P33a/ScaraTwo/Images/IMG20251230002046.jpg

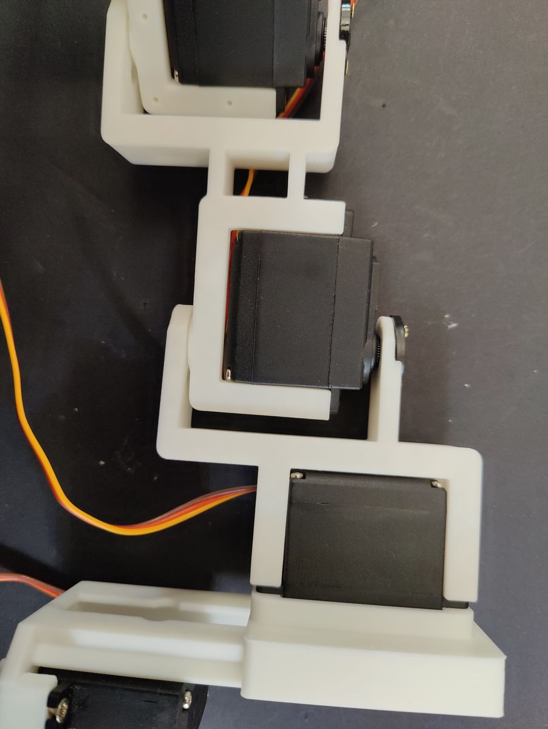
Images/IMG20251230002046.jpg
