P33a/ScaraTwo/STL/claw_left.stl

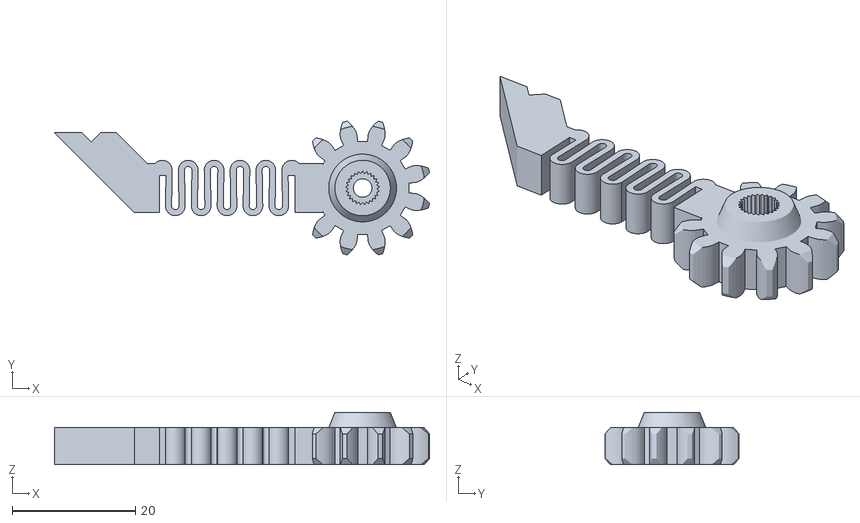
[picture p2: CAD file, 2025-12-30]
STL/claw_left.stl
60.9 x 21.7 x 8.50
