P33a/ScaraTwo/STL/servo55_spacer.stl

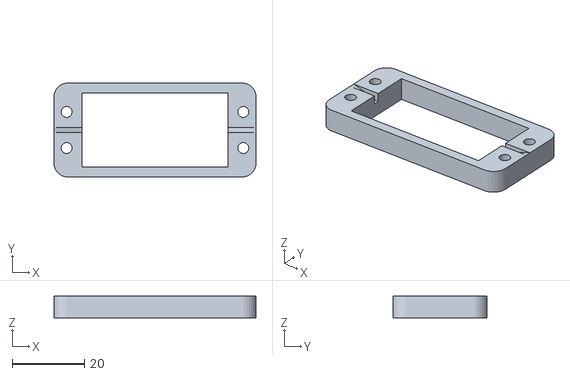
[picture p3: CAD file, 2025-12-30]
STL/servo55_spacer.stl
56.0 x 26.0 x 6.00
