P33a/ScaraTwo/STL/claw_left_v3.stl

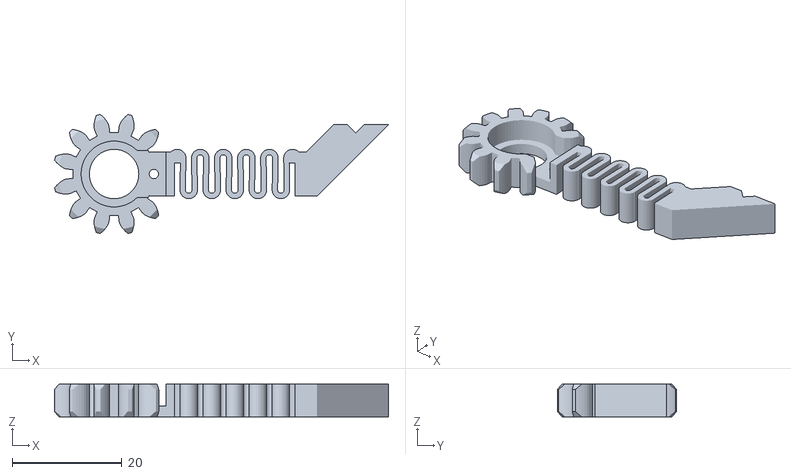
[picture p4: CAD file, 2025-12-30]
STL/claw_left_v3.stl
60.9 x 21.7 x 6.00
