P33a/ScaraTwo/STL/servo55_sleeve.stl

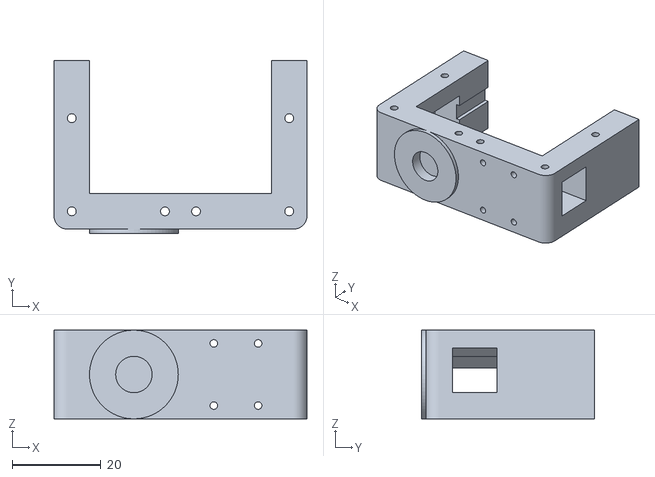
[picture p5: CAD file, 2025-12-30]
STL/servo55_sleeve.stl
57.0 x 39.0 x 20.0
