P33a/ScaraTwo/STL/scara55_slider.stl

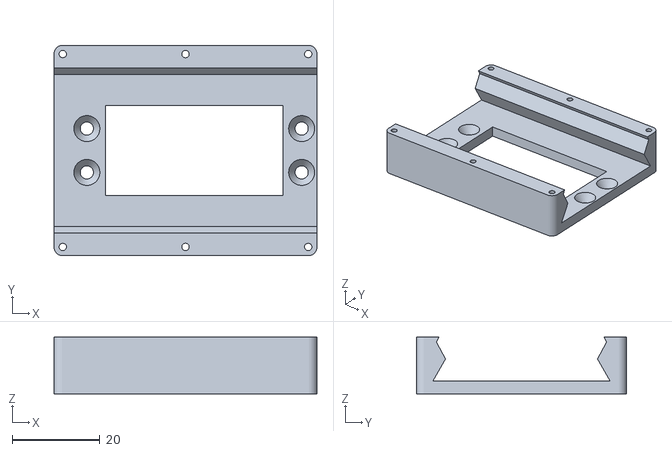
[picture p6: CAD file, 2025-12-30]
STL/scara55_slider.stl
60.0 x 48.0 x 13.0
