P33a/ScaraTwo/STL/as5600_support_55.stl

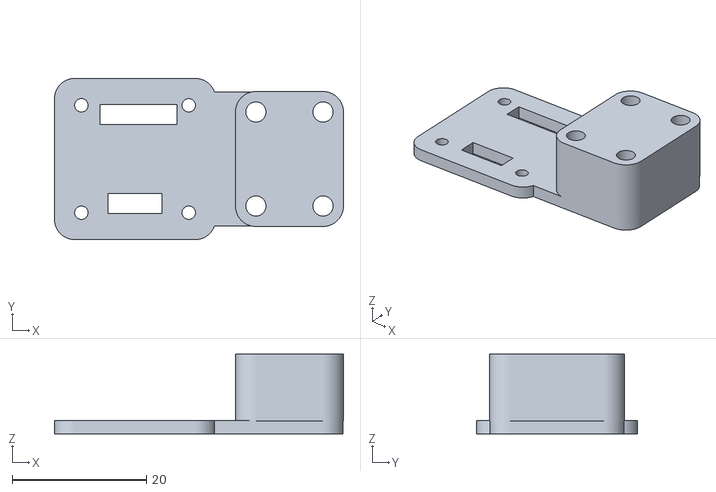
[picture p7: CAD file, 2025-12-30]
STL/as5600_support_55.stl
43.0 x 24.0 x 11.9
