P33a/ScaraTwo/STL/scara55_base.stl

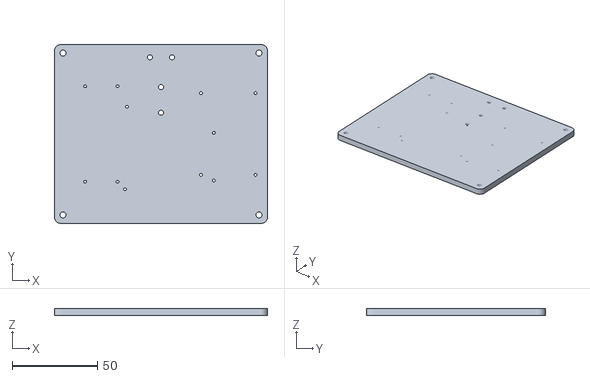
[picture p8: CAD file, 2025-12-30]
STL/scara55_base.stl
125.0 x 105.0 x 4.00
