P33a/ScaraTwo/STL/vlx_support_55_v3.stl

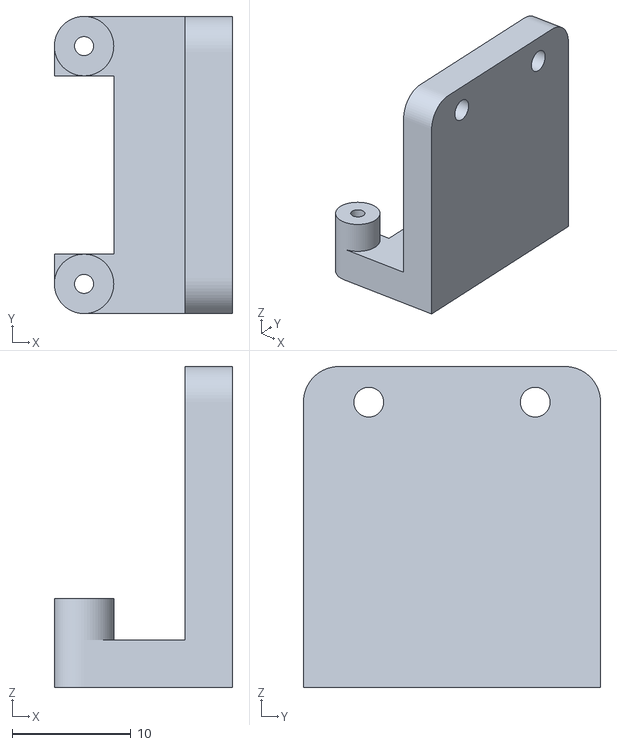
[picture p9: CAD file, 2025-12-30]
STL/vlx_support_55_v3.stl
15.0 x 25.0 x 27.0
