P33a/ScaraTwo/STL/scara55_rail_v3.stl

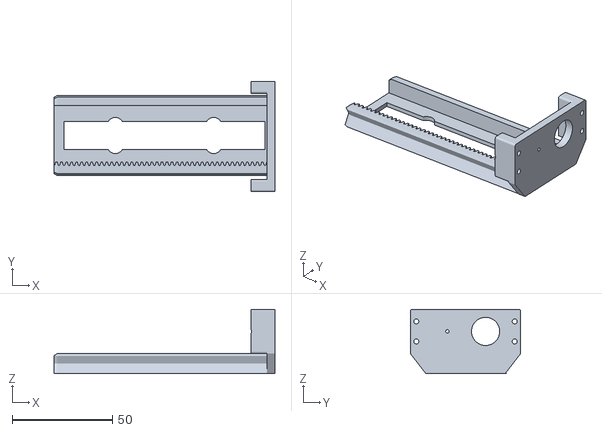
[picture p10: CAD file, 2025-12-30]
STL/scara55_rail_v3.stl
110.0 x 55.0 x 32.1
