P33a/ScaraTwo/STL/scara55_link_two.stl

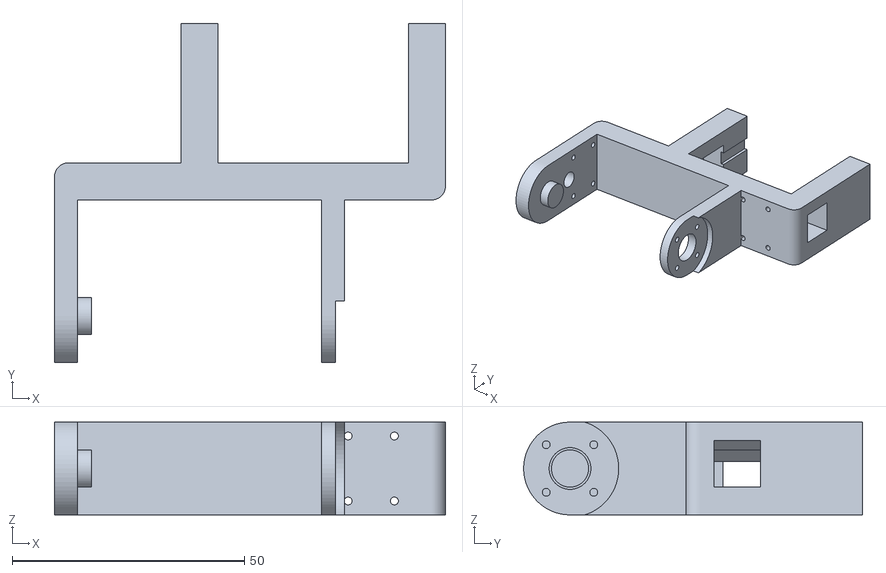
[picture p11: CAD file, 2025-12-30]
STL/scara55_link_two.stl
84.2 x 73.0 x 20.0
