P33a/ScaraTwo/STL/scara55_link_one.stl

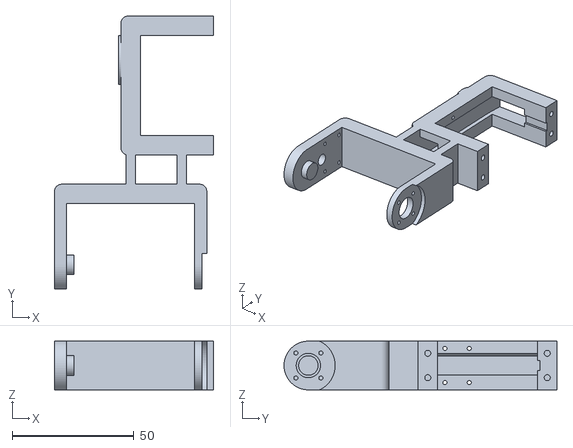
[picture p12: CAD file, 2025-12-30]
STL/scara55_link_one.stl
65.2 x 112.0 x 20.0
