P33a/ScaraTwo/STL/scara55_tower.stl

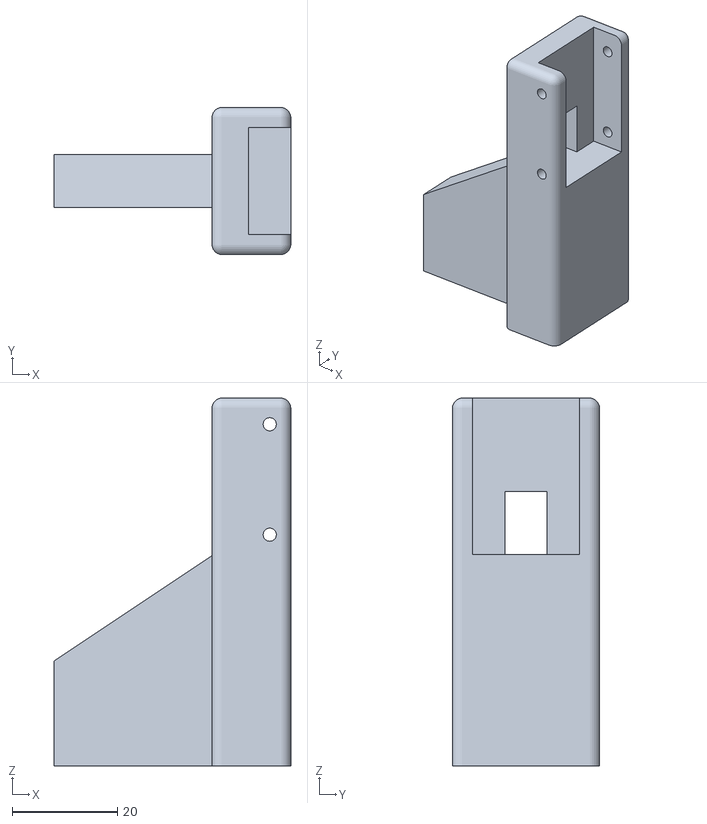
[picture p13: CAD file, 2025-12-30]
STL/scara55_tower.stl
45.0 x 28.0 x 70.0
