P33a/ScaraTwo/STL/claw_pin.stl

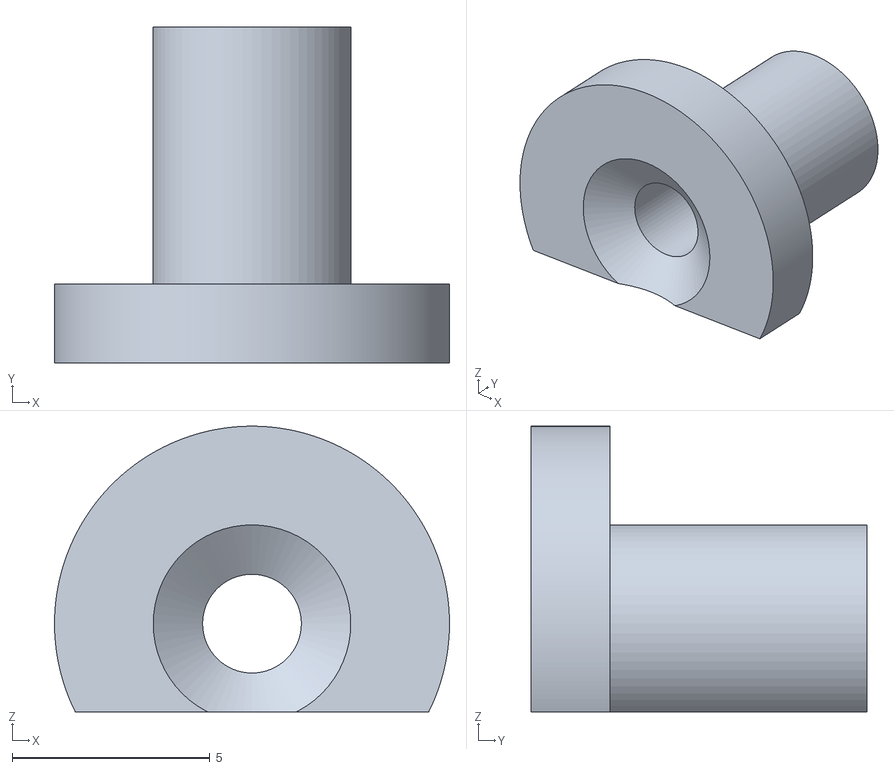
[picture p14: CAD file, 2025-12-30]
STL/claw_pin.stl
10.0 x 8.50 x 7.23
