P33a/ScaraTwo/STL/slider55_gear.stl

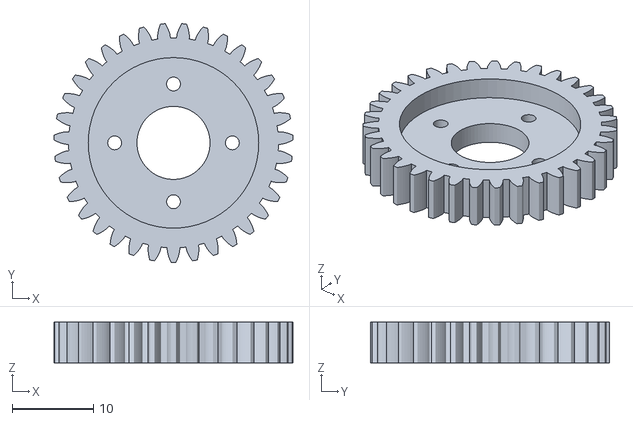
[picture p15: CAD file, 2025-12-30]
STL/slider55_gear.stl
29.4 x 29.4 x 5.00
