P33a/ScaraTwo/STL/vlx_support_55_v2.stl

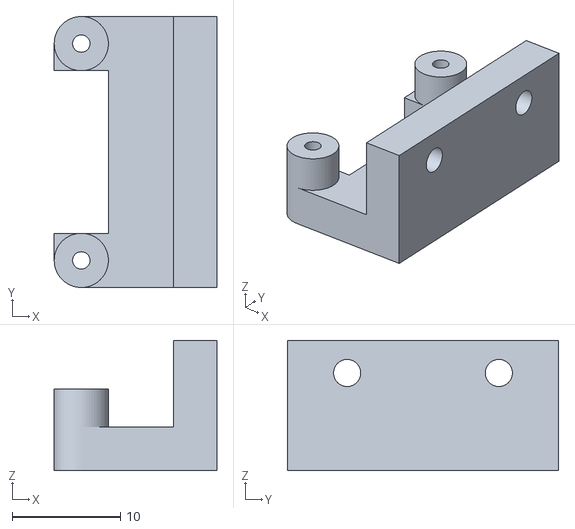
[picture p16: CAD file, 2025-12-30, an earlier design]
STL/vlx_support_55_v2.stl
15.0 x 25.0 x 12.0
