P33a/ScaraTwo/(list of files, cad)

Other CAD files:
STL/claw_right.stl
