P33a/ScaraTwo/Physical Assembly.md

First, the base must be connected to the main tower:

It uses four 3 x 16 mm self tapping screws

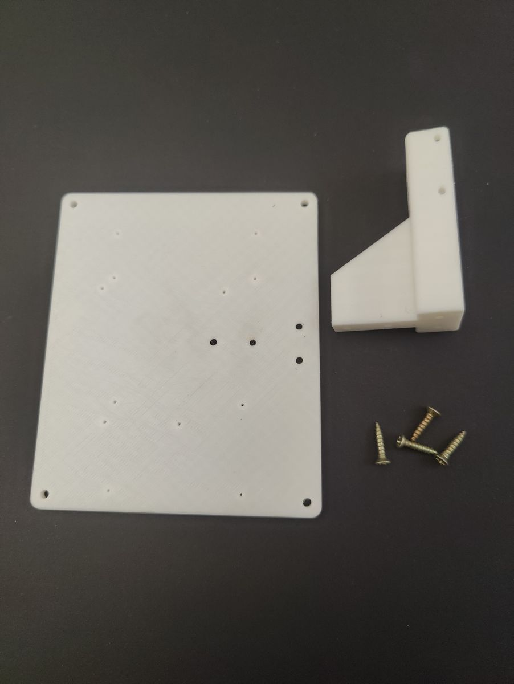
[picture p17: Images/IMG20251128013951.jpg]
 
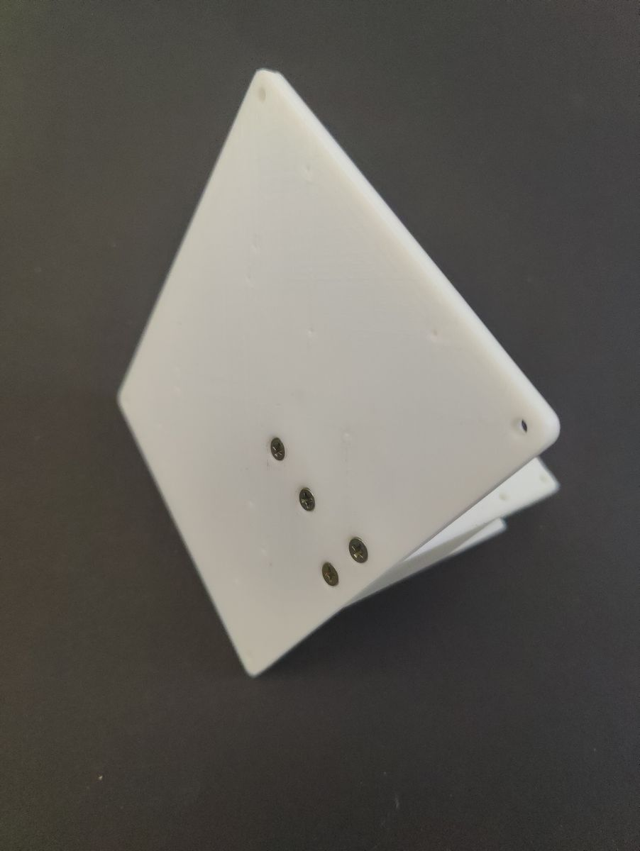
[picture p18: Images/IMG20251128014258.jpg]
 

Final result

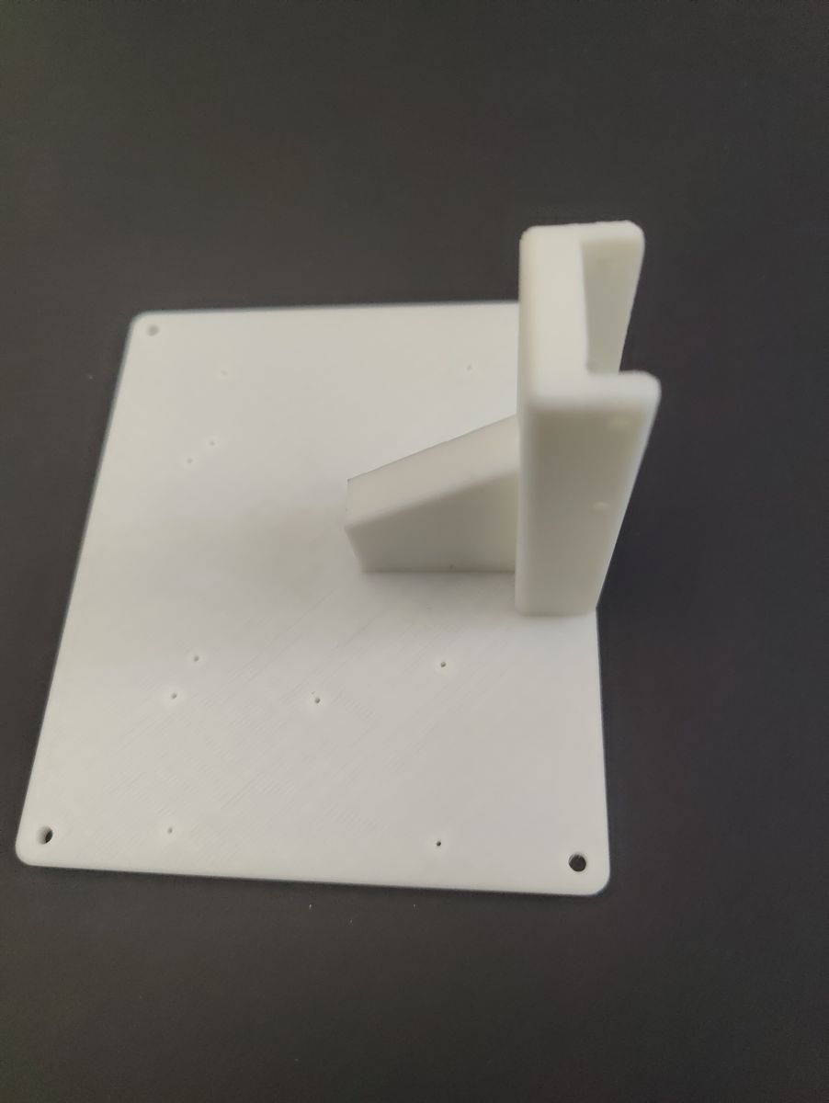
[picture p19: Images/IMG20251128014222.jpg]
 

Connect the Servo sleeve using four 2.5 x 12 mm self tapping screws

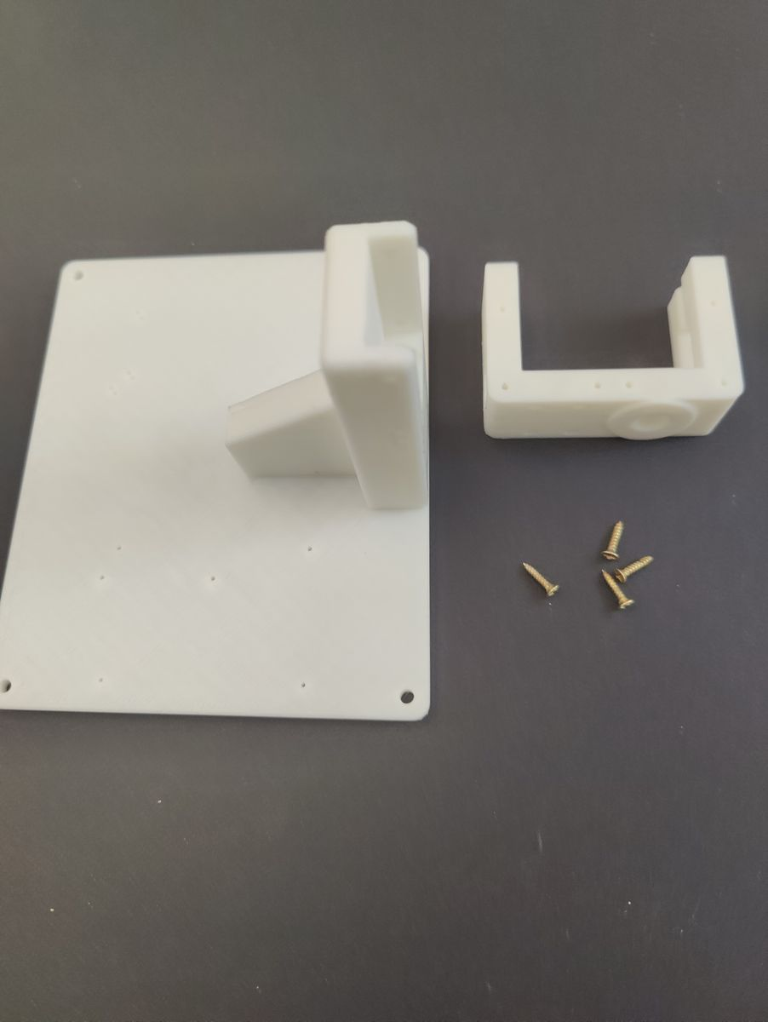
[picture p20: Images/IMG20251128014451.jpg]
 
 
But first attach the Servo to the sleeve using four 2.5 x 16 mm self tapping screws

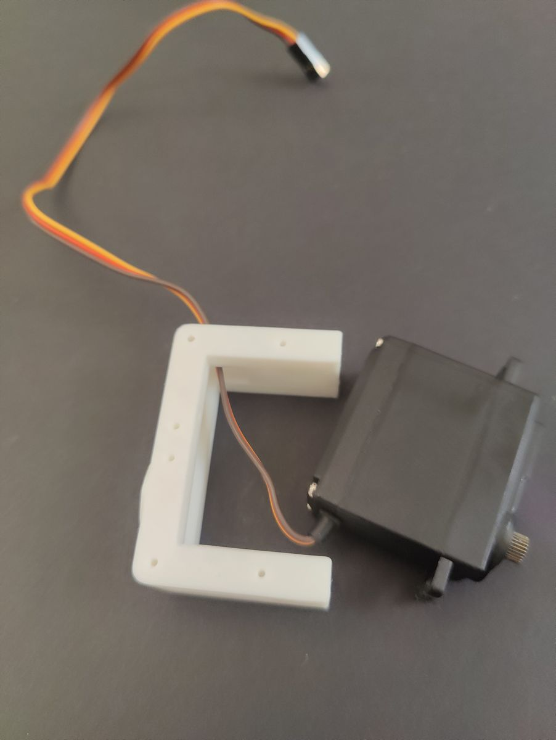
[picture p21: Images/IMG20251128014633.jpg]

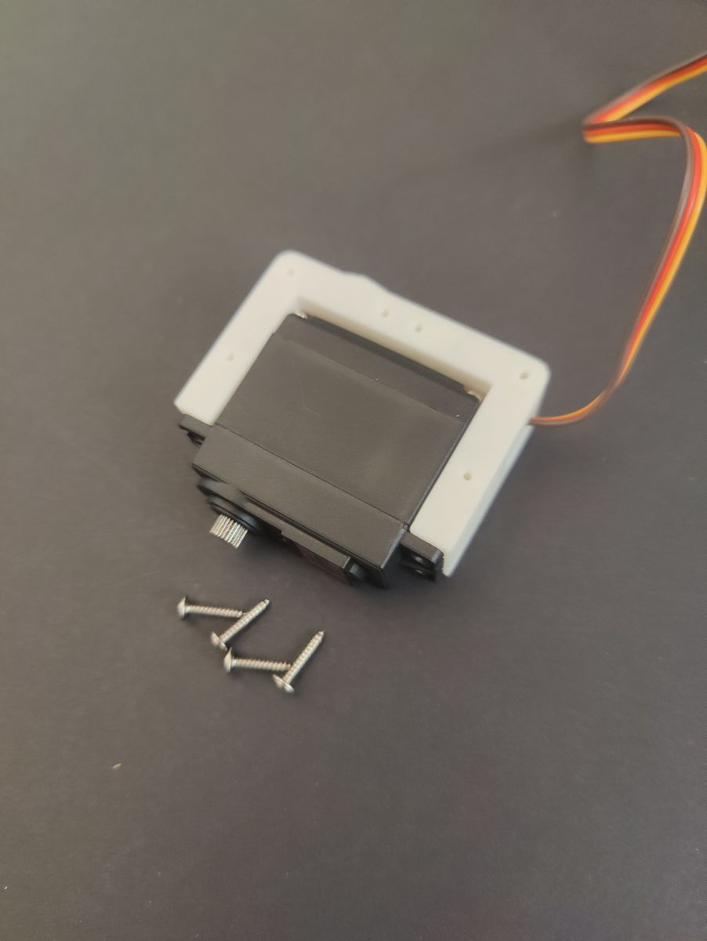
[picture p22: Images/IMG20251128015108.jpg]

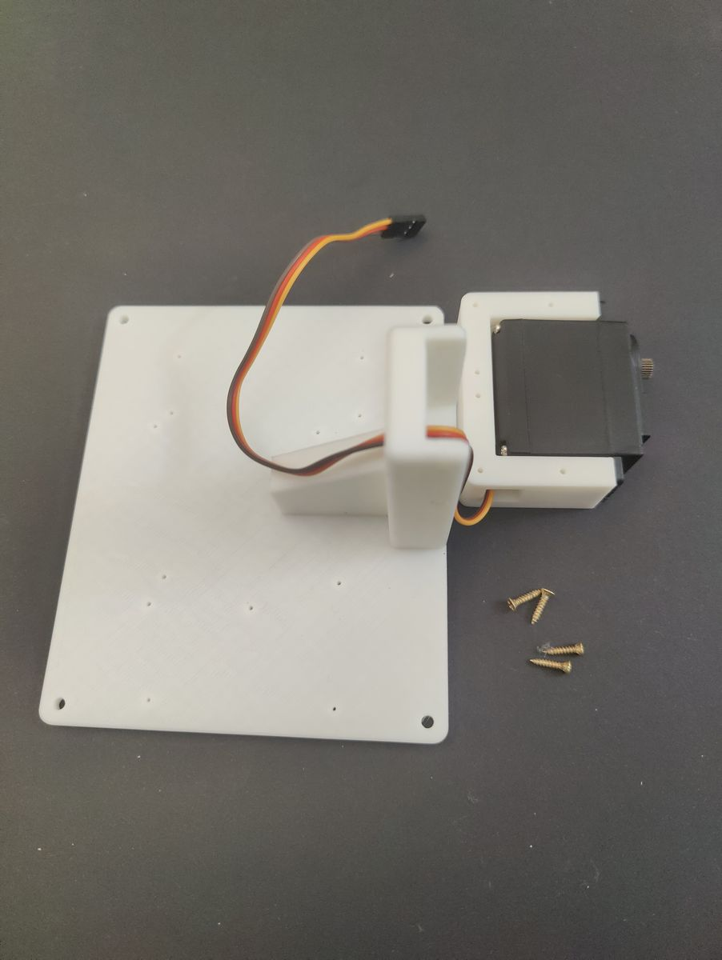
[picture p23: Images/IMG20251128015253.jpg]

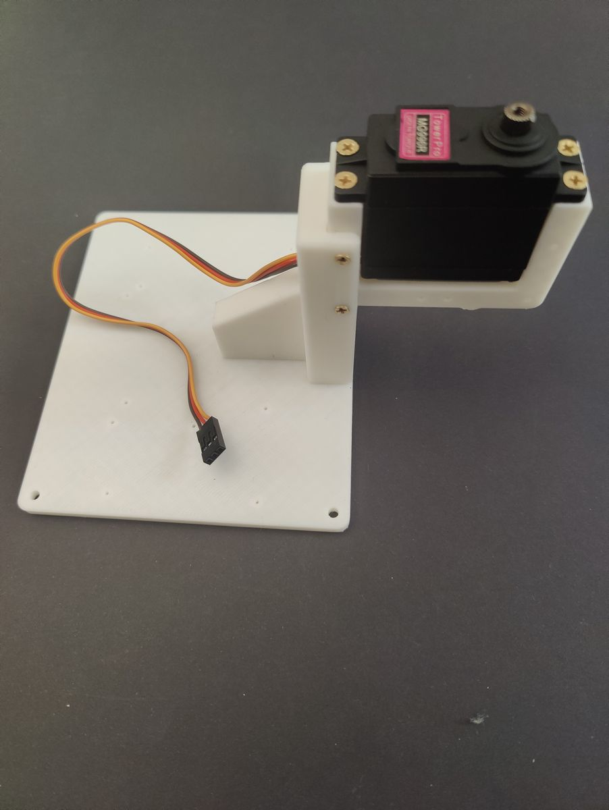
[picture p24: Images/IMG20251128015450.jpg]


Then, attach the second Servo to the first link.
Again, use four 2.5 x 16 mm self tapping screws

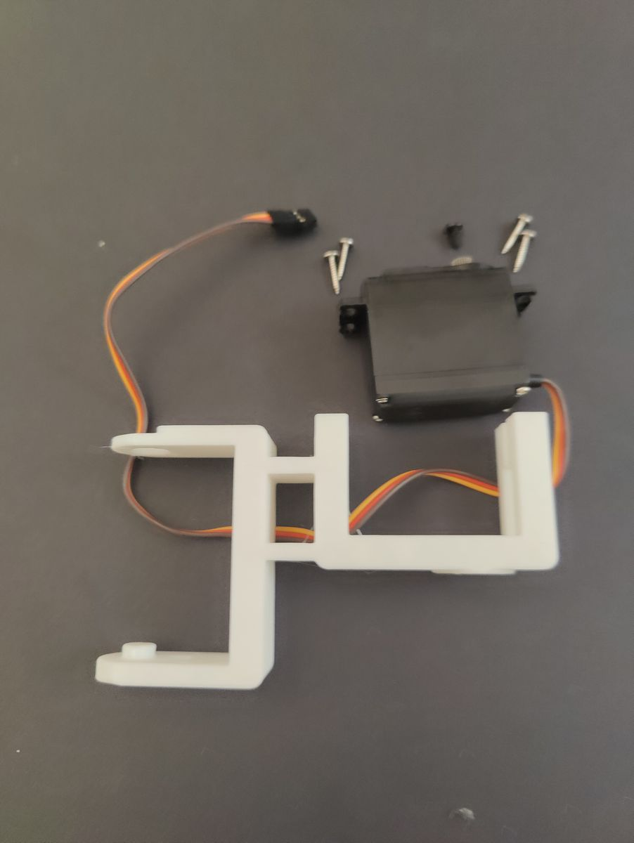
[picture p25: Images/IMG20251128015823.jpg]

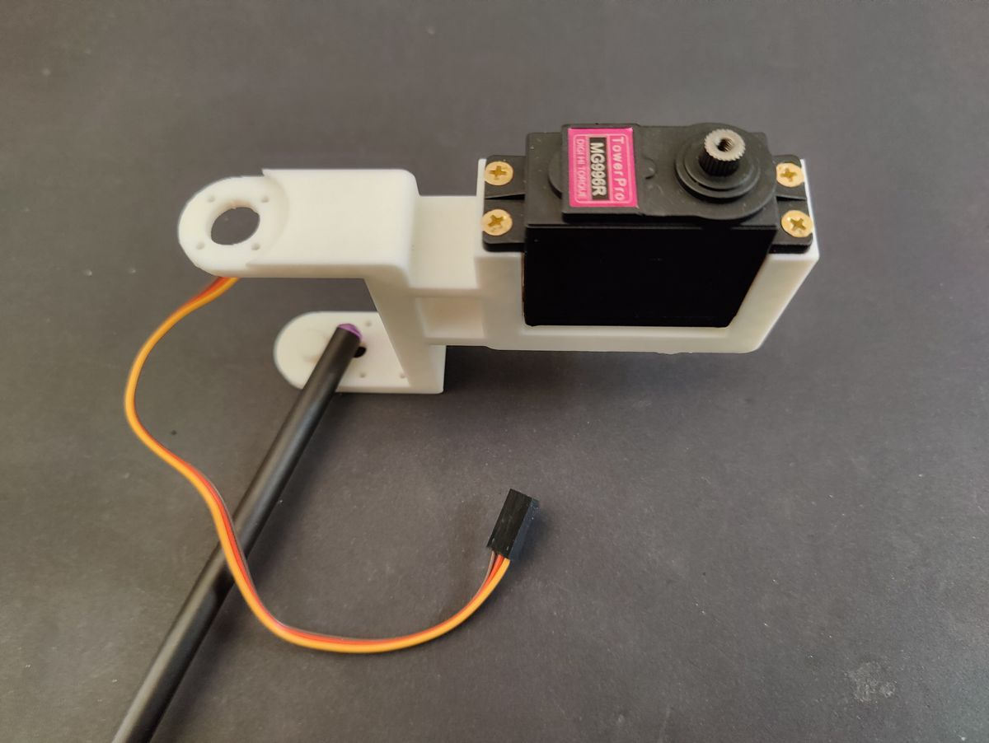
[picture p26: Images/IMG20251229225830.jpg]
  

The Servo round horn must be attached to the first link 
using two (or four) 2 x 6 mm self tapping screws

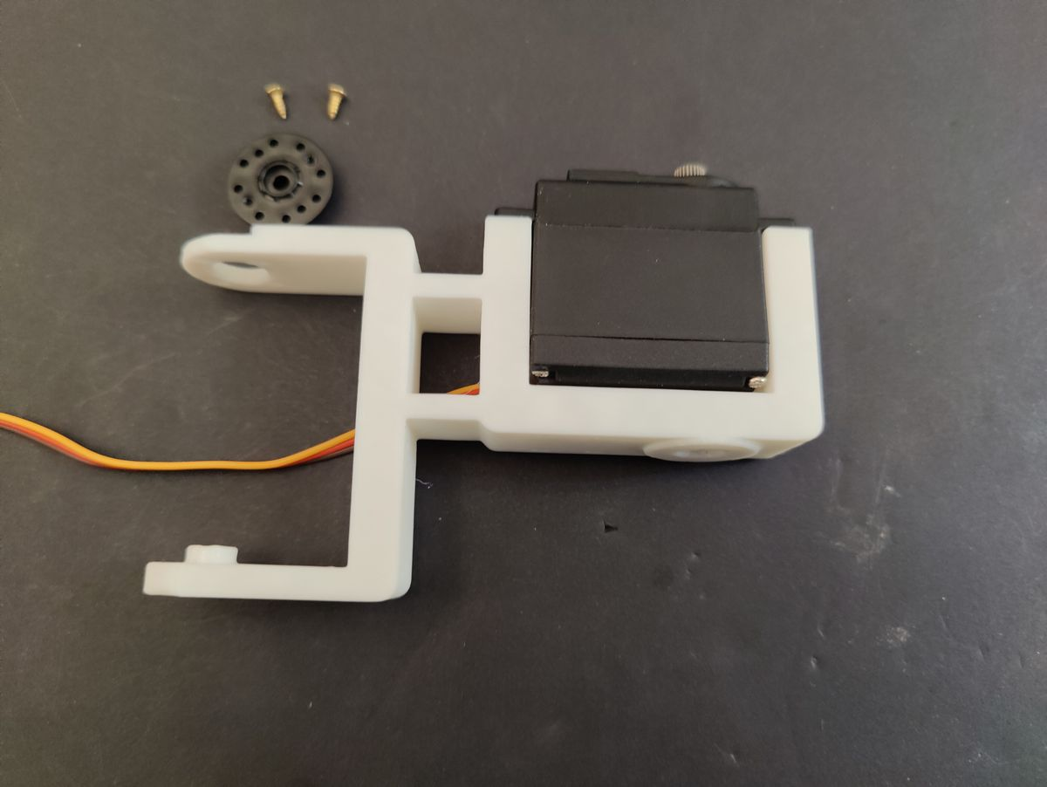
[picture p27: Images/IMG20251229231113.jpg]

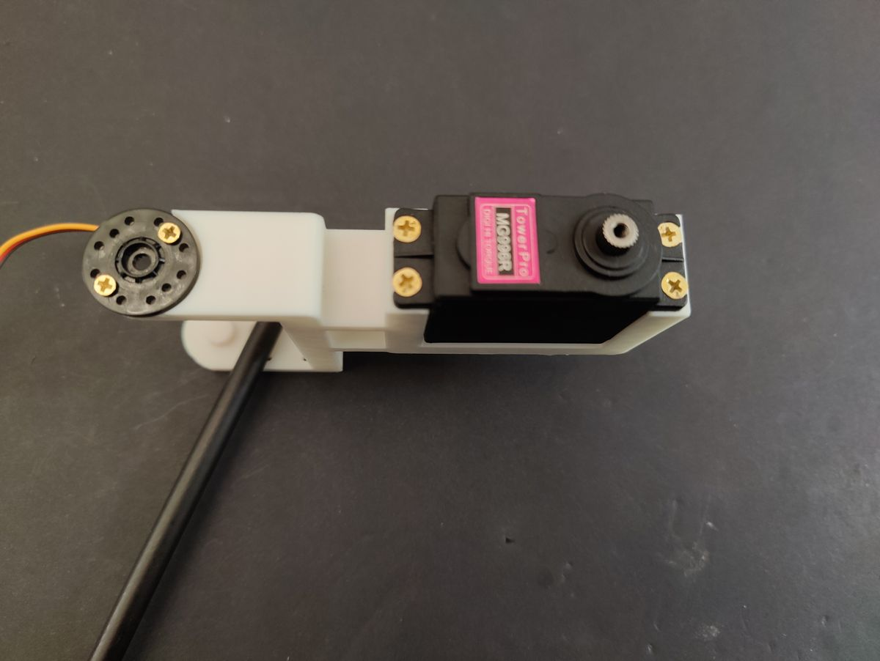
[picture p28: Images/IMG20251229231228.jpg]
  

Press the horn to insert it on the first servo.
Use the supplied screw to hold it.

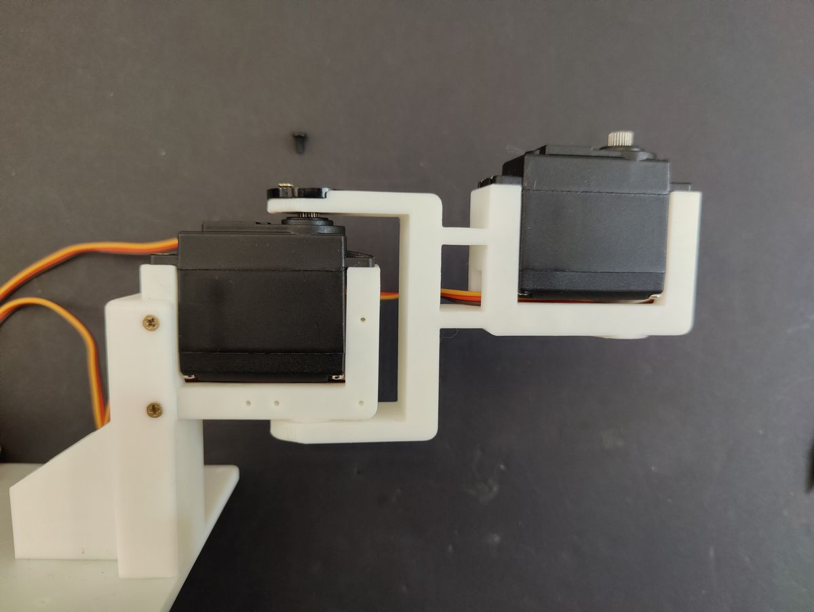
[picture p29: Images/IMG20251229231446.jpg]


To assemble the Z joint you will need four  2.5 x 20 mm self tapping screws

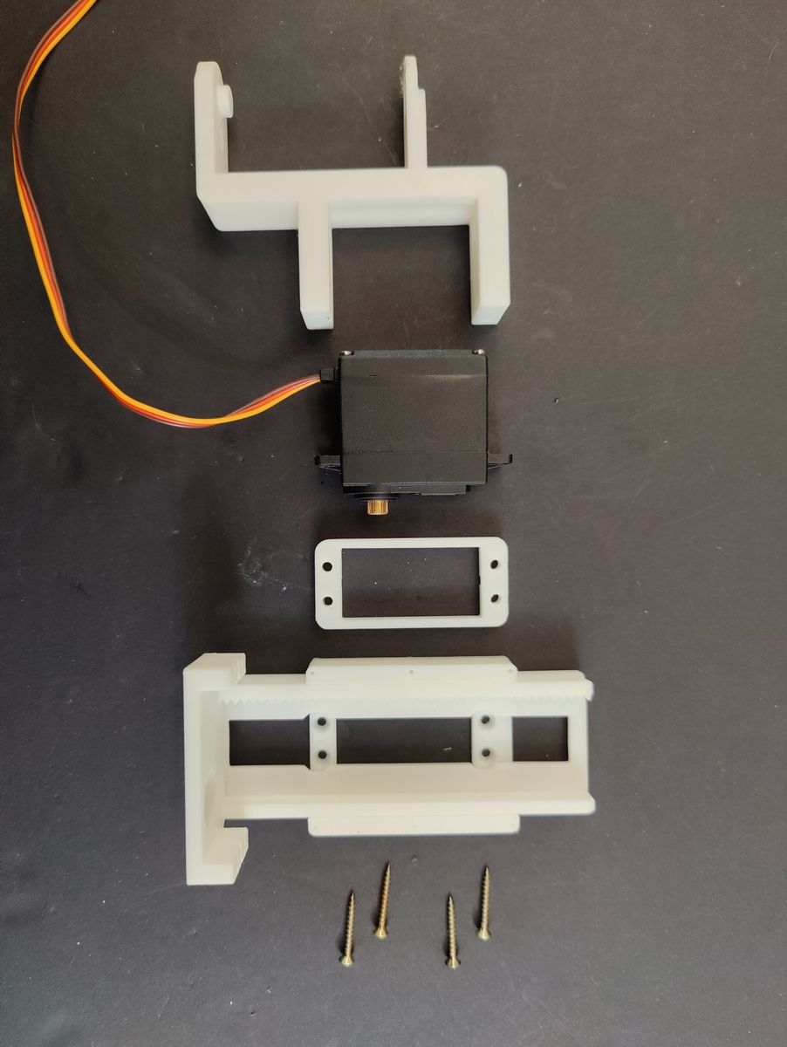
[picture p30: Images/IMG20251229234037.jpg]

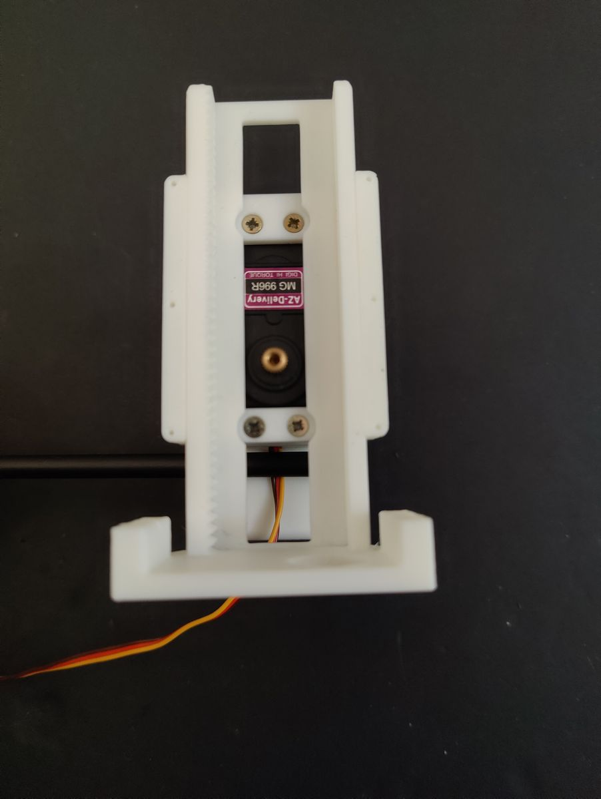
[picture p31: Images/IMG20251229234408.jpg]


The gear must be attached to the round horn using two (or four) 2 x 6 mm self tapping screws

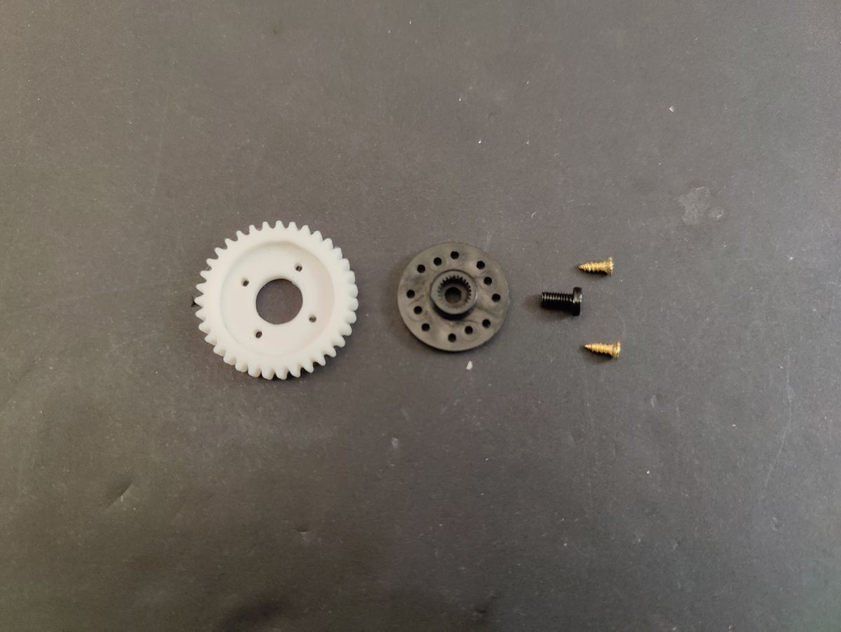
[picture p32: Images/IMG20251229234536.jpg]


and then use the supplied screw to atttach it to the servo.

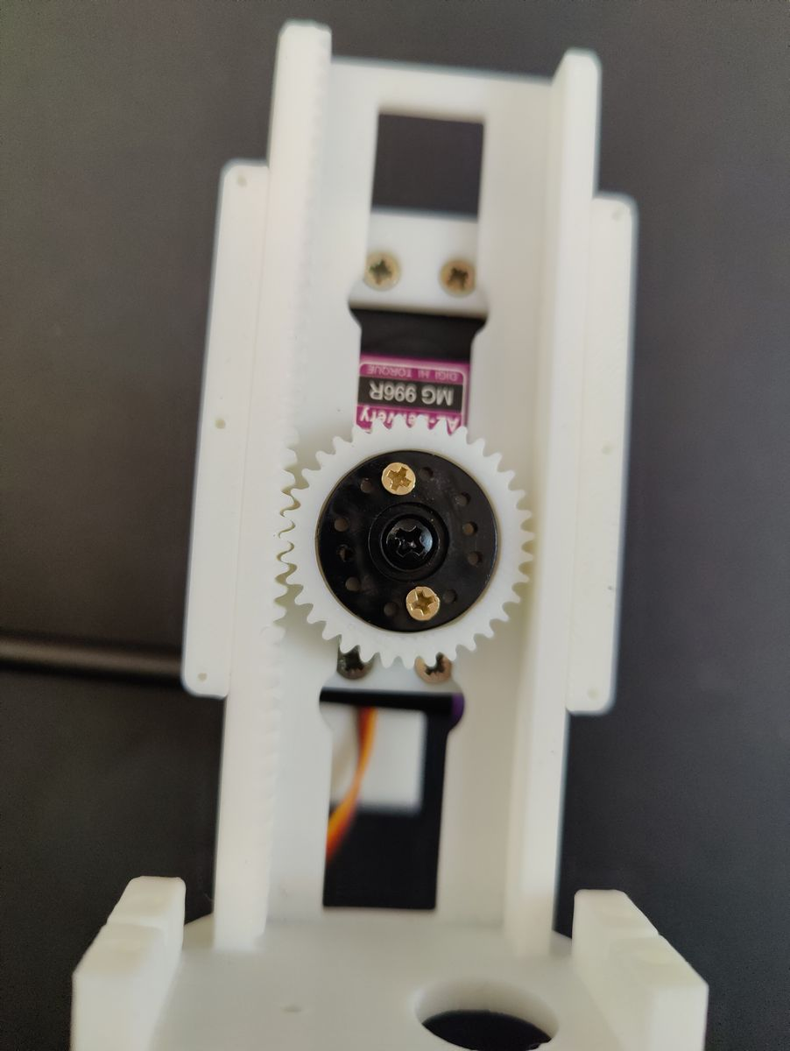
[picture p33: Images/IMG20251229234749.jpg]


The claw Servo must be attached using four 2.5 x 12 mm self tapping screws

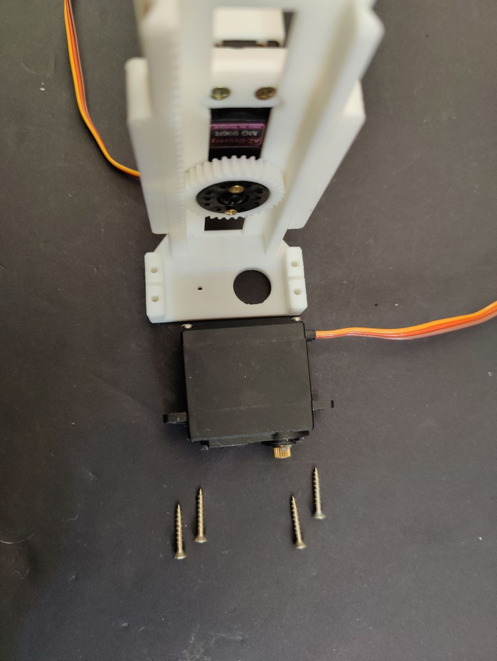
[picture p34: Images/IMG20251229235720.jpg]

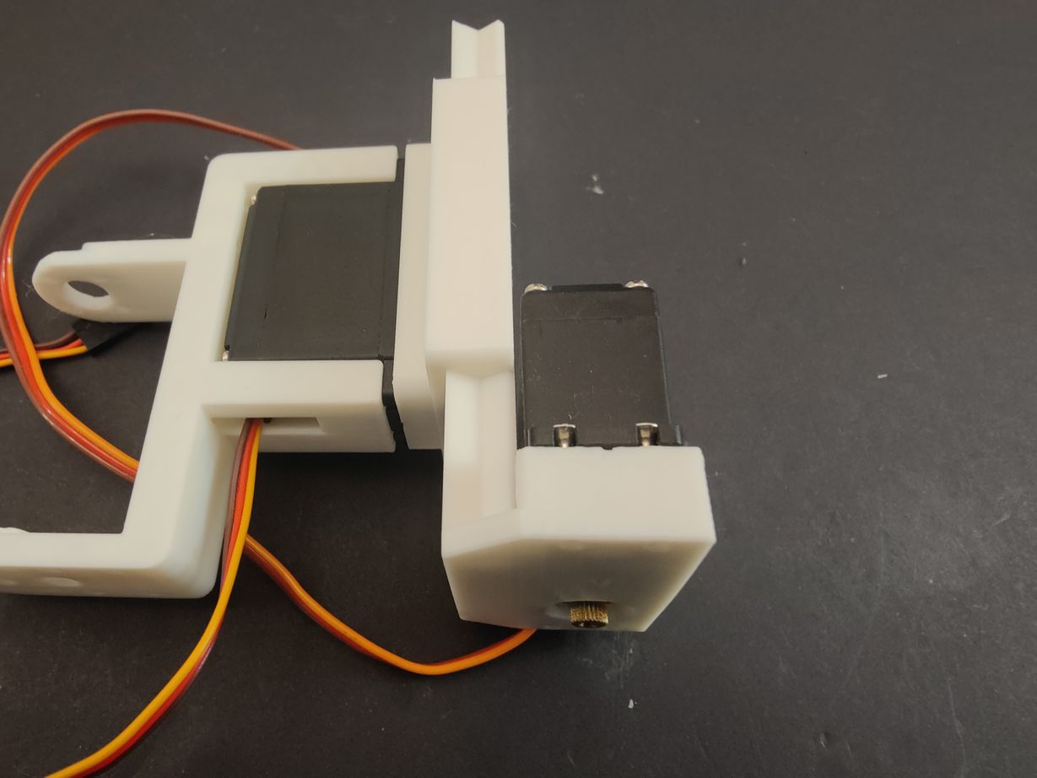
[picture p35: Images/IMG20251230000154.jpg]


One claws wil be attached  to the servo using the servo screw and a modified horn

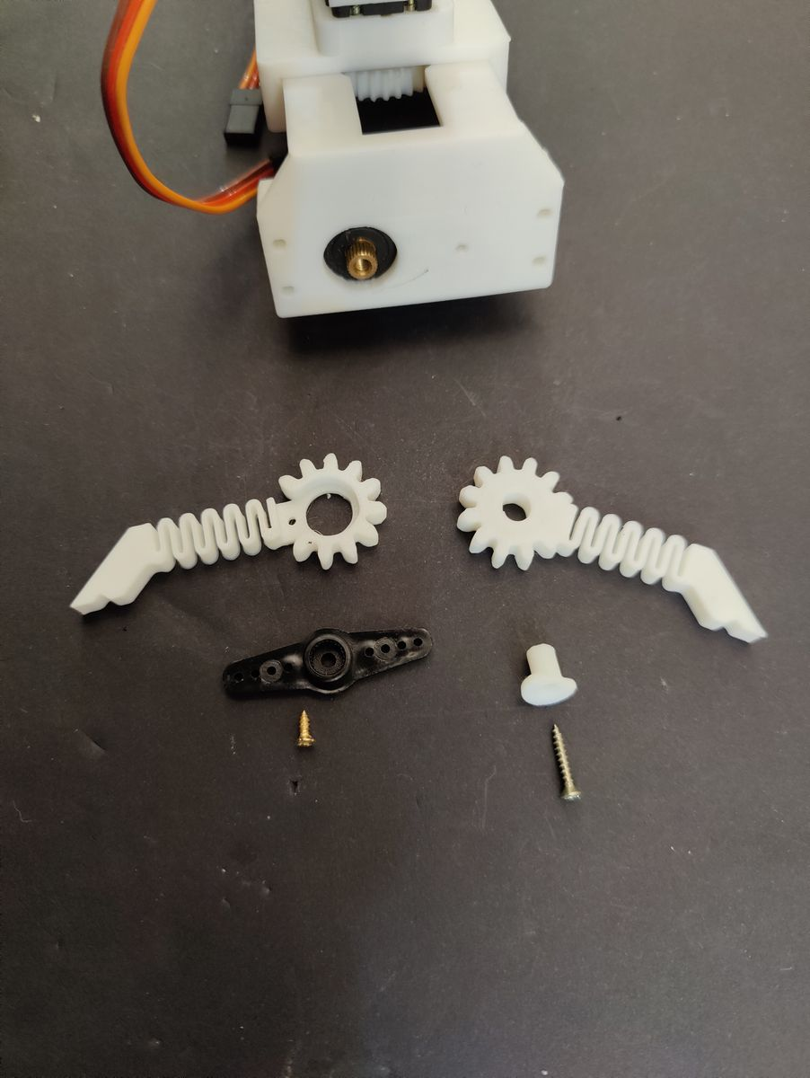
[picture p36: Images/IMG20251230000459.jpg]

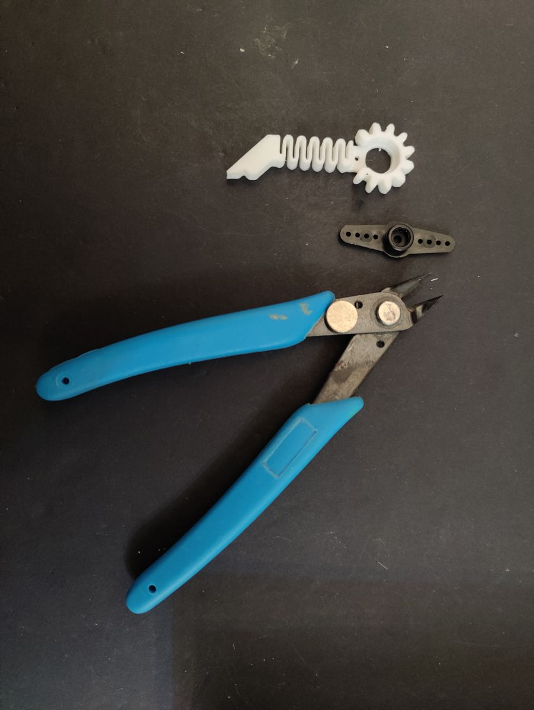
[picture p37: Images/IMG20251230000532.jpg]


The original horn with the first cut:

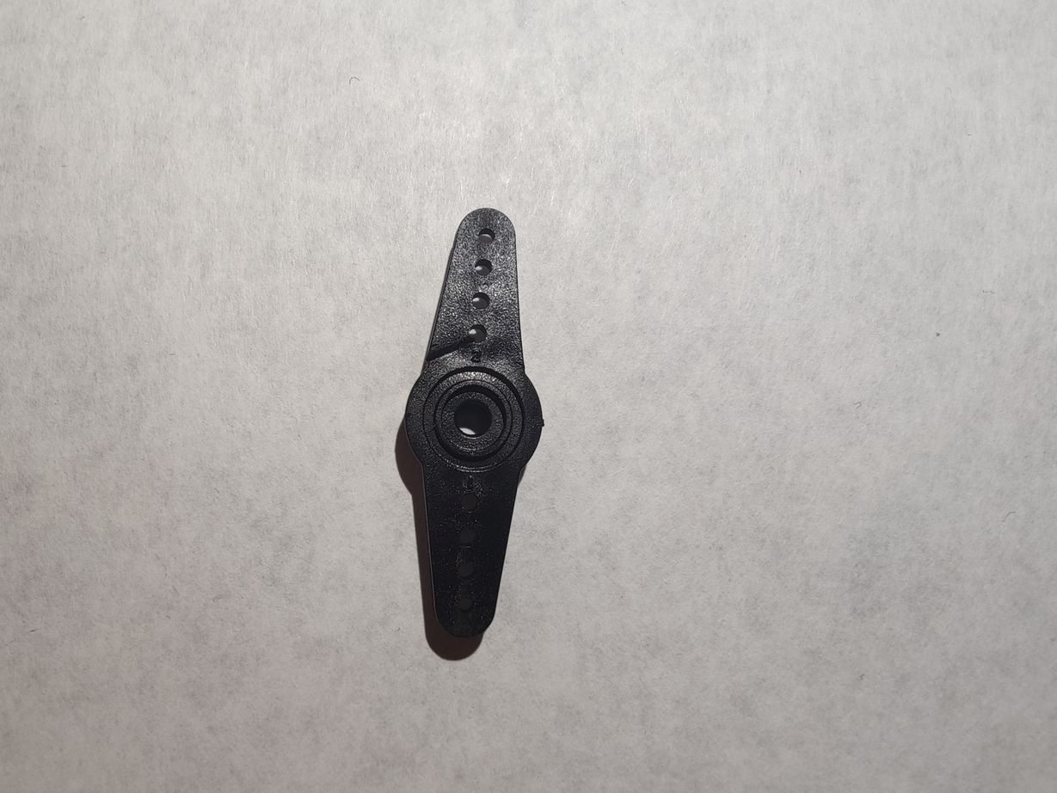
[picture p38: Images/IMG20251230000651.jpg]


The horn with the final modification and attached to the claw using a 2 x 6 mm self tapping screw

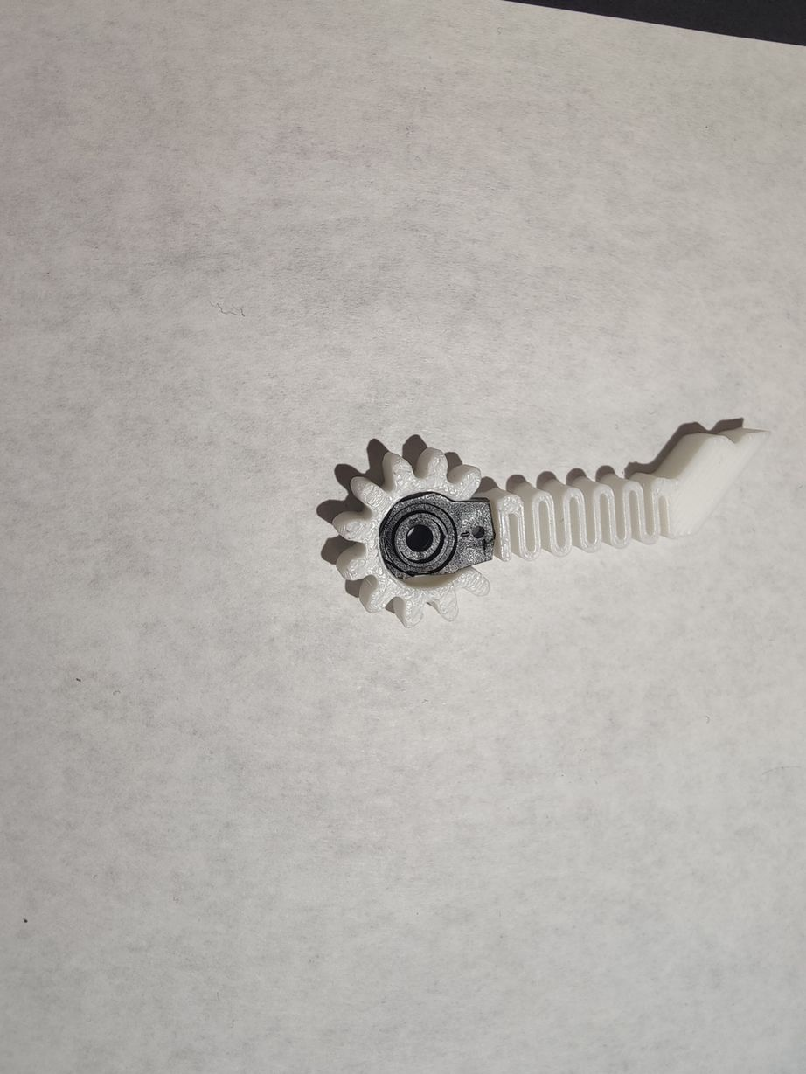
[picture p39: Images/IMG20251230000946.jpg]


The other claw attache using a 2 x 12 mm self tapping screw

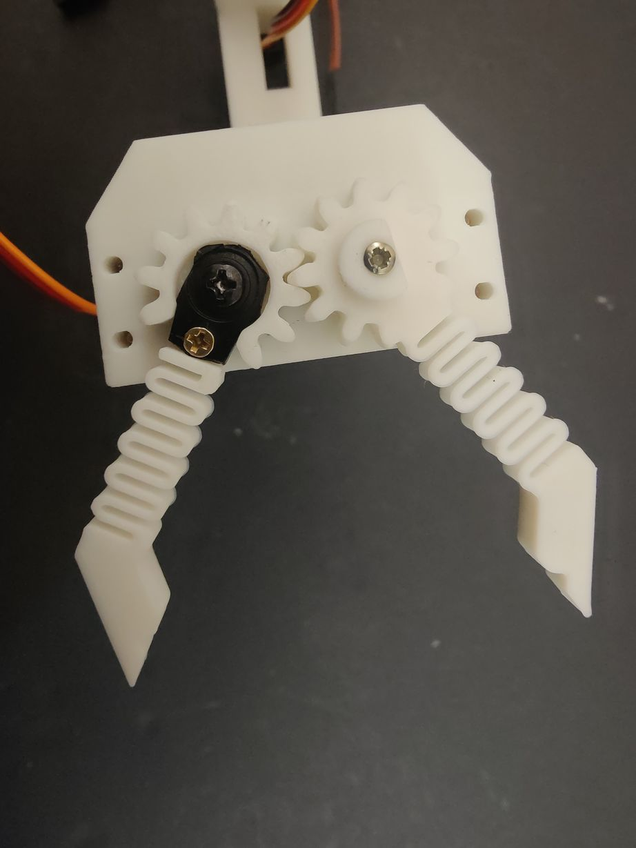
[picture p40: Images/IMG20251230001525.jpg]


The final connection between the first two links and the rest of the arm

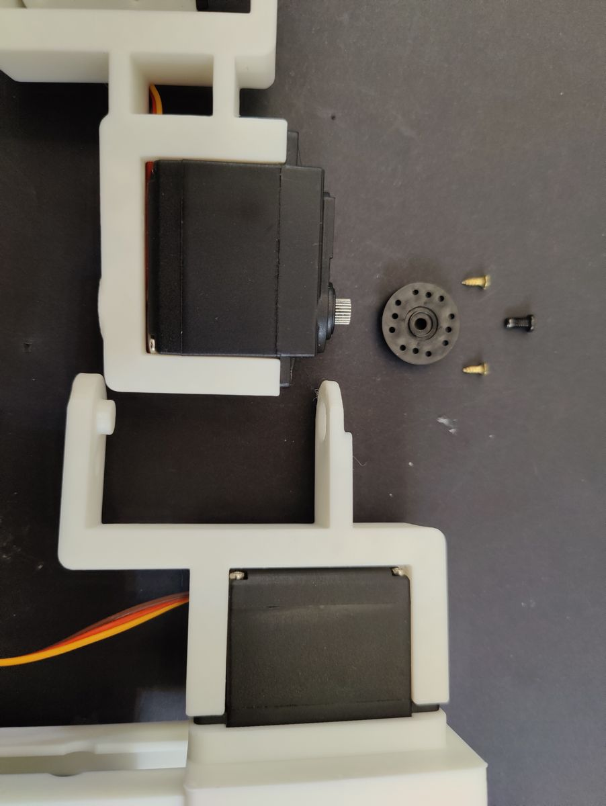
[picture p41: Images/IMG20251230001711.jpg]
final

final

Now you can secure the servo driver board and the Pi Pico motherboard.
First, the Pi Pico motherboard using four 2 x 10 mm self tapping screws and four washers as the booard holes are larger than the screw heads.

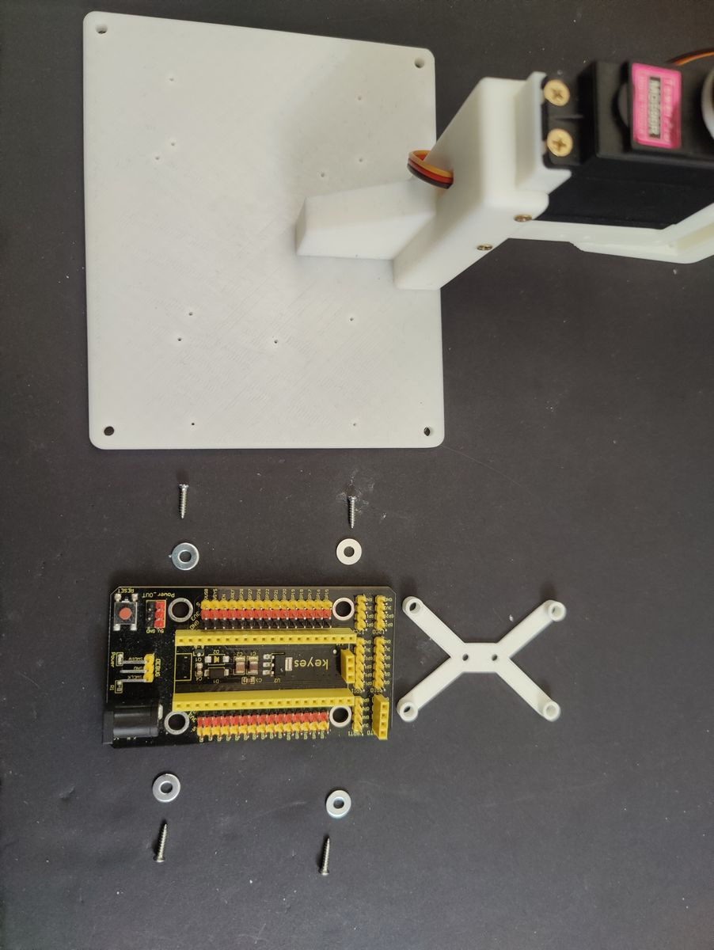
[picture p42: Images/IMG20260118232020.jpg]

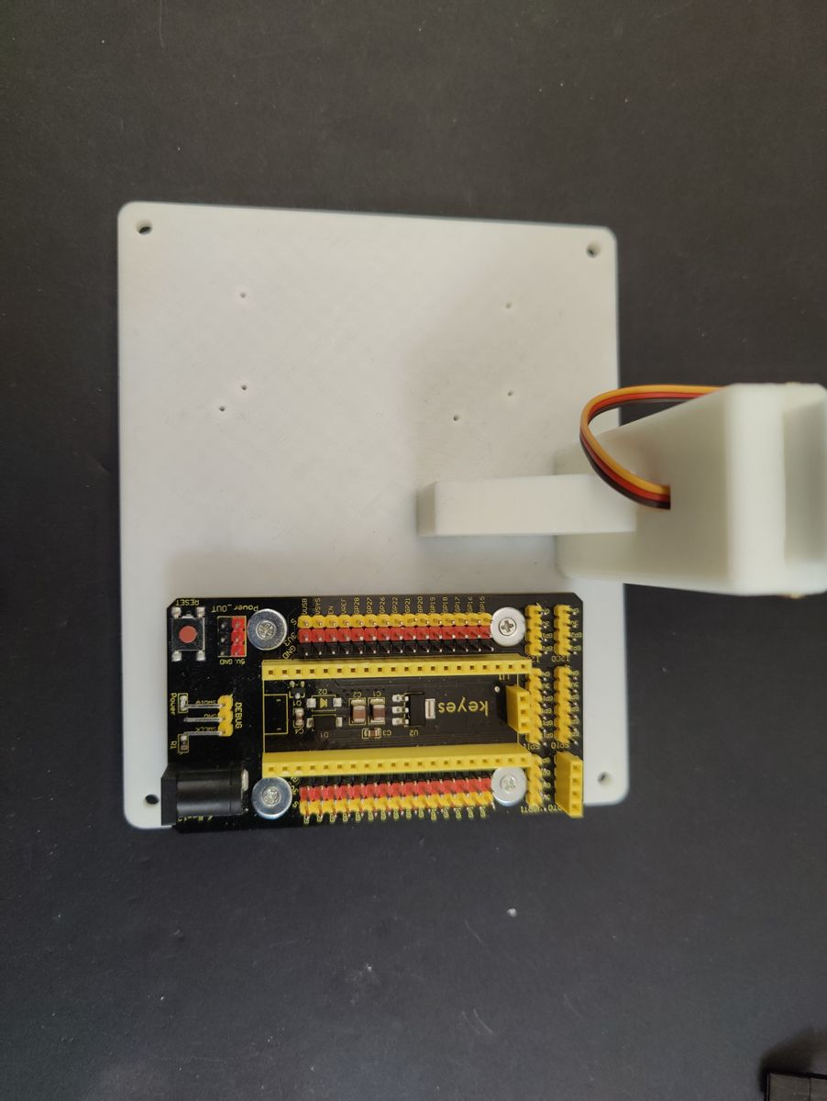
[picture p43: Images/IMG20260118232312.jpg]


Then, the servo driver board using four 2 x 10 mm self tapping screws.

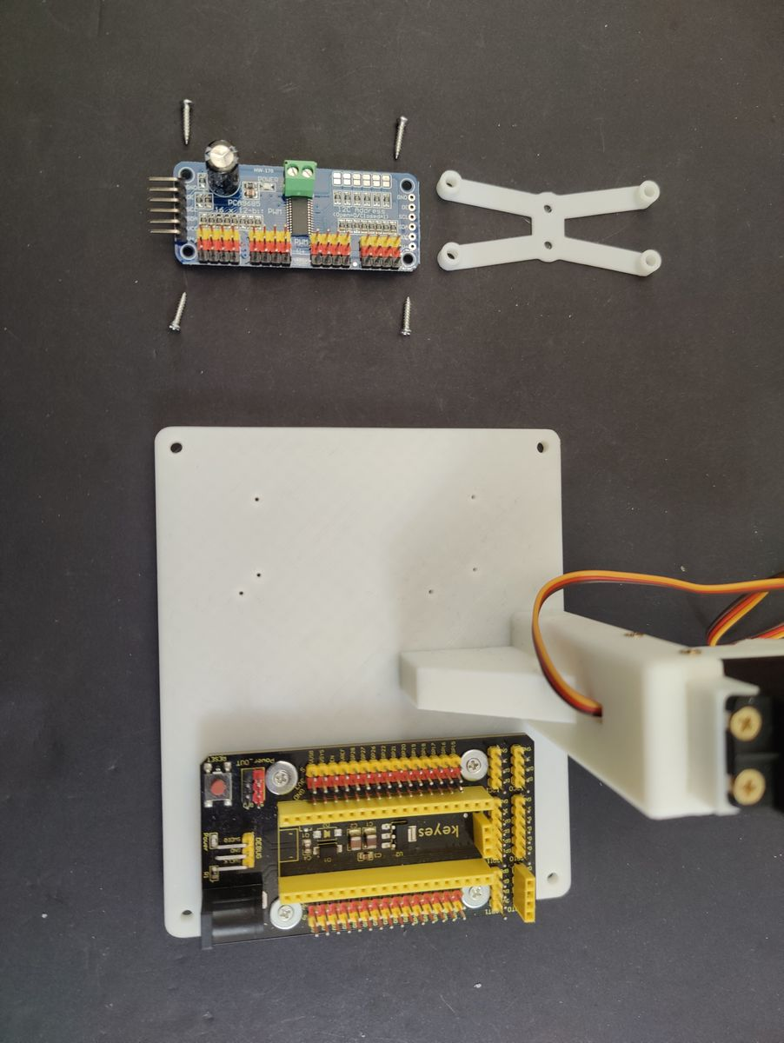
[picture p44: Images/IMG20260118232356.jpg]

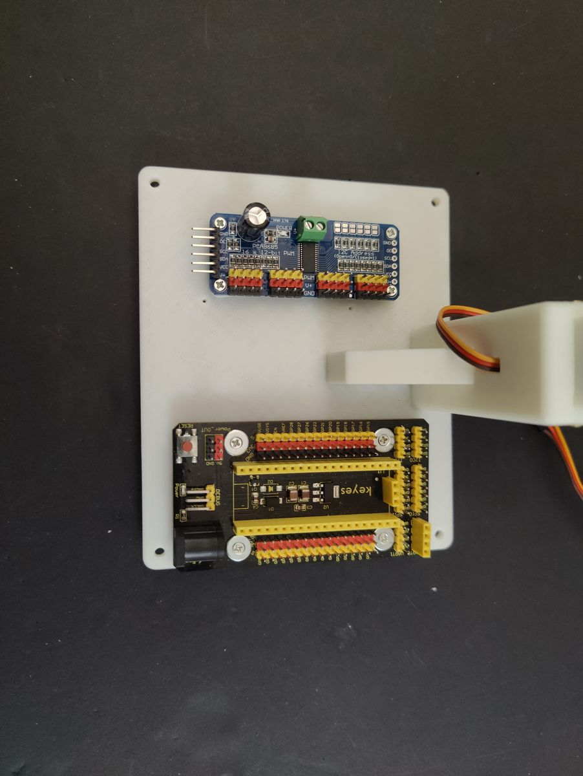
[picture p45: Images/IMG20260118232608.jpg]


Now, for the optional sensors

If the first two servos are 360º servos you will need an extra position sensor for those joints

You must secure the sensor to its support using four 2 x 6 mm self tapping screws.

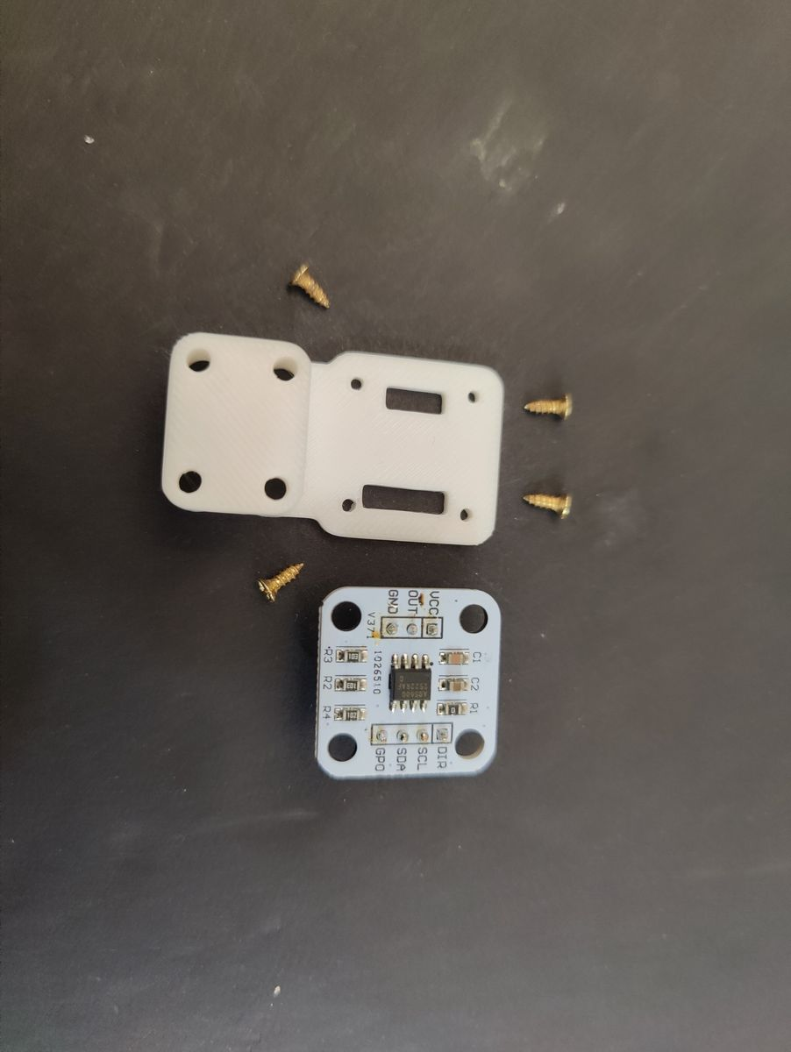
[picture p46: Images/IMG20260118234412.jpg]

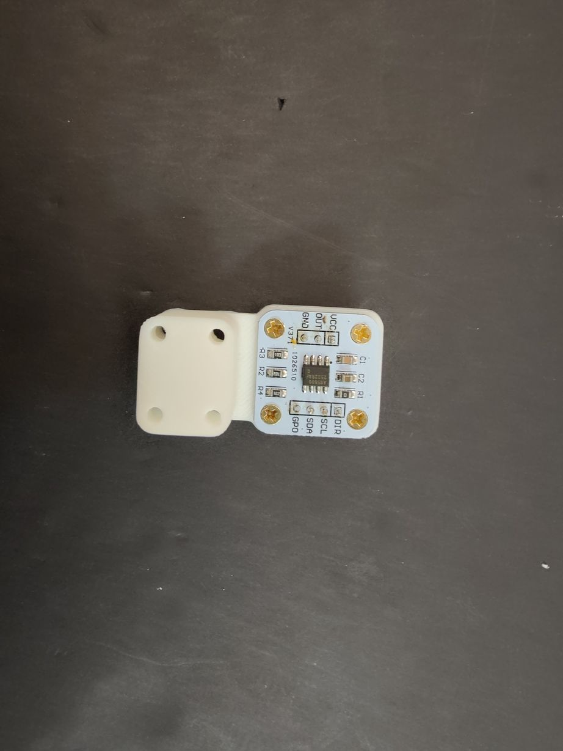
[picture p47: Images/IMG20260118234547.jpg]


Then you can secure it to the link using four 2 x 10 mm self tapping screws.

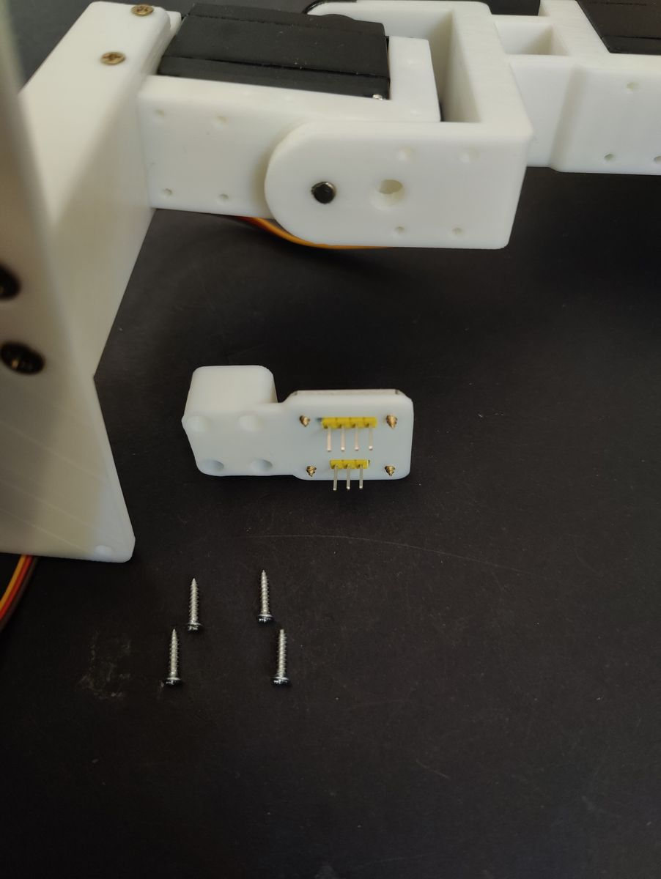
[picture p48: Images/IMG20260118234703.jpg]

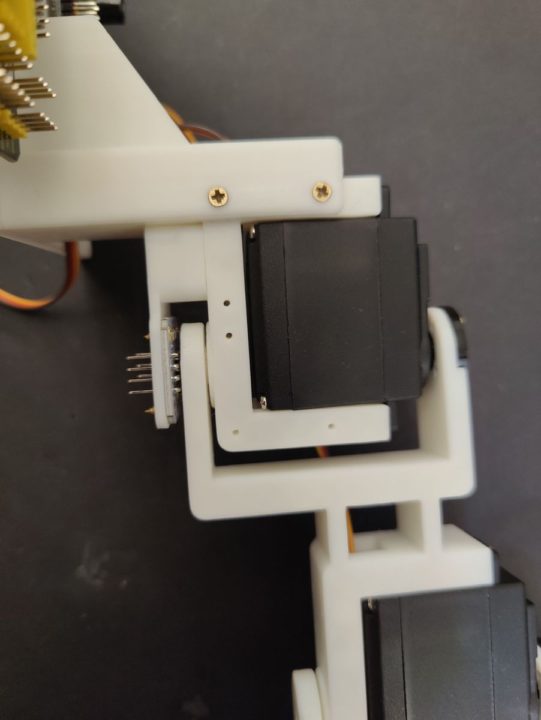
[picture p49: Images/IMG20260118234837.jpg]


If you want the distance sensor connected to the arm
First you must secure the sensor to its support using two 2 x 10 mm self tapping screws.

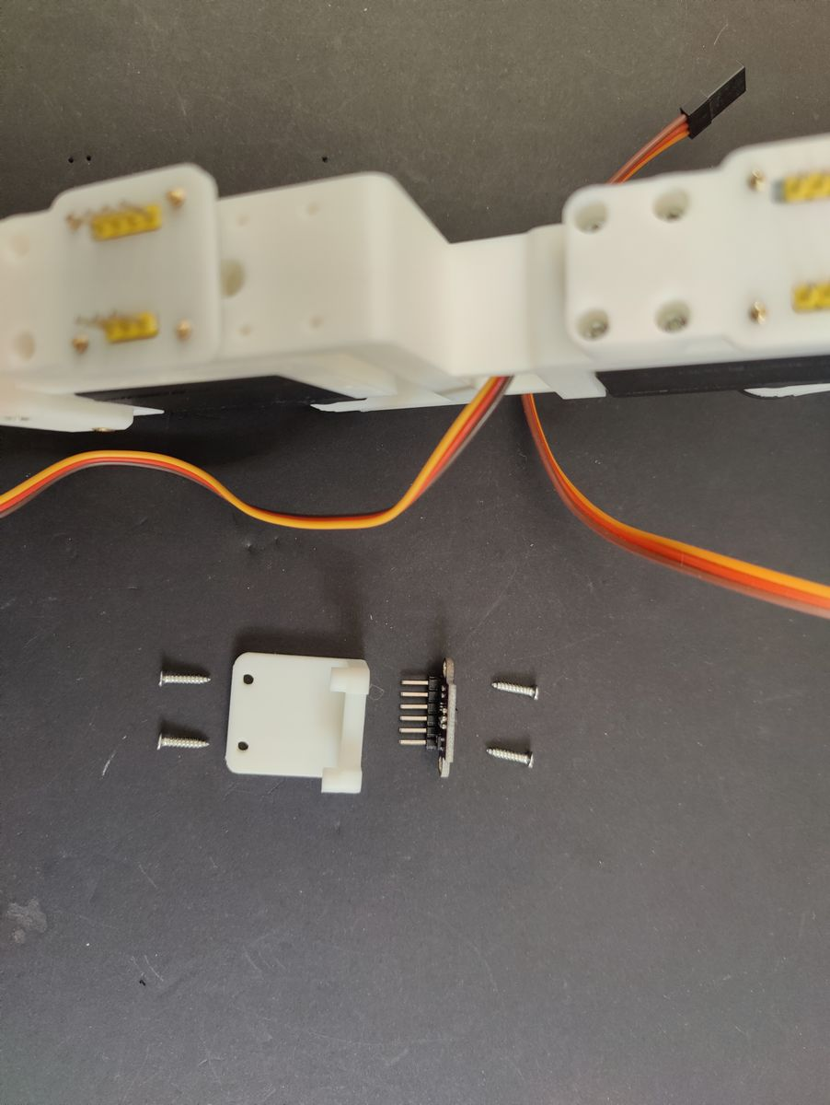
[picture p50: Images/IMG20260119001107.jpg]

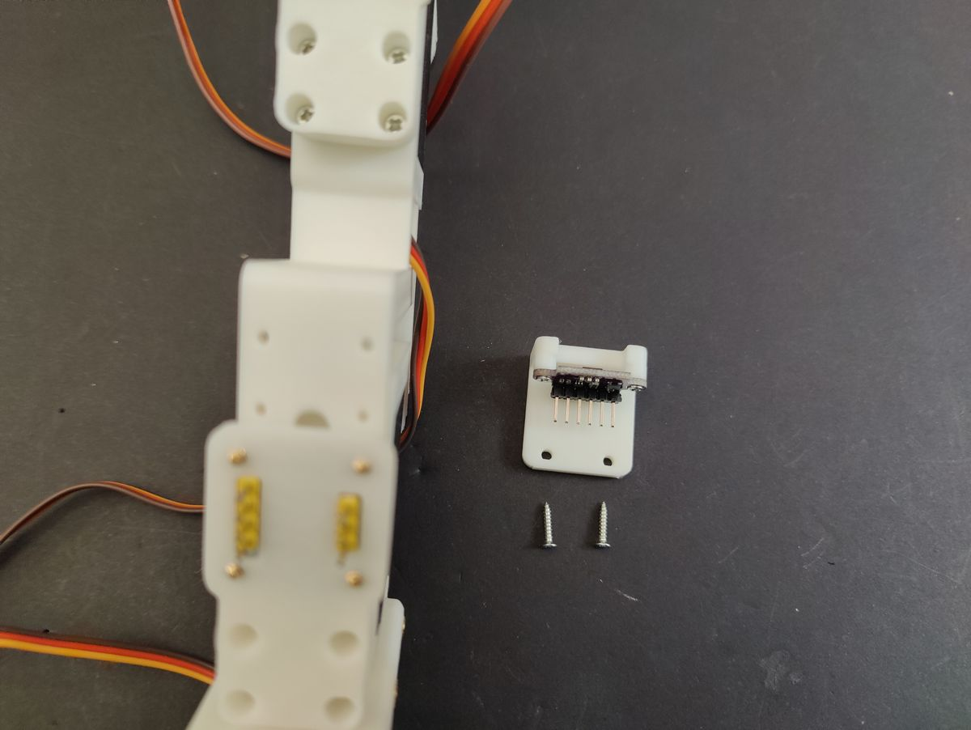
[picture p51: Images/IMG20260119001307.jpg]


Then you can secure it to the link using four 2 x 10 mm self tapping screws.
Do not forget to press the magnet inside the hole alligned with the link axis.

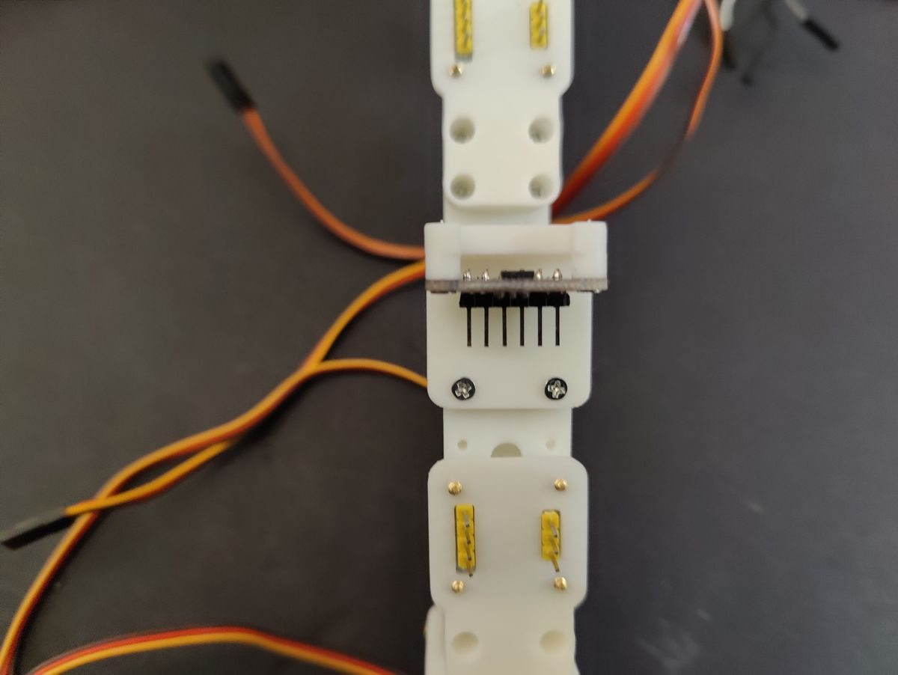
[picture p52: Images/IMG20260119001418.jpg]

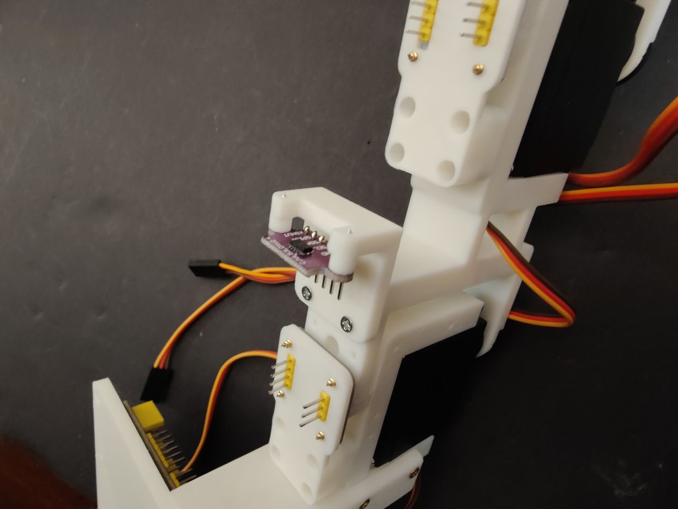
[picture p53: Images/IMG20260119001431.jpg]
