P33a/ScaraTwo/(commit log)

2025-12-30 STL Files
    [as5600_support_55.stl, claw_left.stl, claw_left_v3.stl, claw_pin.stl, claw_right.stl, scara55_base.stl, scara55_link_one.stl, scara55_link_two.stl]
2025-12-30 Create Physical Assembly.md
2025-12-30 Update Physical Assembly.md
